shJoshDing/SenkoMicro-SKCS-Firmware/SKSC_Firmware_RevB/Readme.txt

V1.26
1. a GPIO is used to control External power Relay to achive POWER ON and POWER OFF operations;
2. discard debug flashLED();

V1.270/271 2014/08/12
1. uart for power supply control

V1.28 2014/08/12
1. spi flash programe;
2. monite fuse number in flash
