shJoshDing/SenkoMicro-SKCS-Firmware/Hardware Docs/RevC SCH and Gerber/SDP-B GPIO REVC.xlsx

Sheet: Signal Define
CON | Pin Name | Pin Number | IO Number | Signal CTL | High | Low
A | PH1 | 78 | GPIO01
A | PH2 | 44 | GPIO02
A | PH3 | 77 | GPIO03
A | PH0 | 43 | GPIO04
A | PH5 | 76 | GPIO05
A | PH6 | 47 | GPIO06
A | PH7 | 74 | GPIO07
B | PH10 | 43 | GPIO08
B | PH12 | 44 | GPIO09
B | PH14 | 45 | GPIO10
A | PF9 | 37 | GPIO11
A | PF12 | 38 | GPIO12
B | PH15 | 76 | GPIO13
B | PH13 | 77 | GPIO14
B | PH11 | 78 | GPIO15
A | PH8 | 85 | GPIO16
A | PF7 | 31 | GPIO17
A | PF6 | 32 | GPIO18
A | PF3 | 88 | GPIO19
A | PF2 | 92 | GPIO20
B | PF15 | 31 | GPIO21
B | PF14 | 32 | GPIO22
B | PF13 | 87 | GPIO23
B | PG14 | 35 | GPIO24
B | PF11 | 89 | GPIO25
B | PF10 | 90 | GPIO26
B | PF8 | 91 | GPIO27
B | PG15 | 41 | GPIO28

Sheet: Mode Control
IO Name | GPIO2 | GPIO3 | GPIO11 | GPIO4 | Signal Path | Mode | Note
Set 1 | low | low | low | high | AIN -----VCS | Current Measure
Set 2 | low | low | high | high | AIN -----VREF | VREF Measure
Set 3 | low | high | low | high | CONFIG----VCS | X
Set 4 | low | high | high | high | CONFIG----VREF | X
Set 5 | high | low | low | high | AIN-----VOUT | VOUT Measure
Set 6 | high | low | low | low | AIN-----MOUT | MOUT Measure
Set 7 | high | low | high | high | AIN-----510OUT | 510OUT Measure
Set 8 | high | high | low | high | CONFIG----VOUT | Digital Control
Set 9 | high | high | high | high | CONFIG----510OUT | +/-15V Digital Control

Sheet: Power Control
Power | Voltage | Status | GPIO7 | GPIO8 | GPIO9 | GPIO10
VDD | 5V | Power On | high | low | x | x
 | 6V | Power On | low | high | x | x
 | GND | Power Off | high | high | x | x
-15V | -15V | Power On | x | x | low | x
 | GND | Power Off | x | x | high | x
+15V | +15V | Power On | x | x | x | high
 | GND | Power Off | x | x | x | low
