shJoshDing/SenkoMicro-SKCS-Firmware/Hardware Docs/RevB SCH/HDR defines.xlsx

Pin Number | Signal Name
2 | VDD
3 | GND
4 | VOUT
5 | VREF
