shJoshDing/SenkoMicro-SKCS-Firmware/Hardware Docs/RevB SCH/SDP-B GPIO REVB.xlsx

Sheet: Signal Define
CON | Pin Name | Pin Number | IO Number | Signal CTL | High | Low
A | PH1 | 78 | GPIO1 | EVDD | current sensor | no current sensor
A | PH2 | 44 | GPIO2 | SKCS | from Vout/510 out | from VCS/VREF
A | PH3 | 77 | GPIO3 | SKCS | to CONFIG | to AIN
A | PH0 | 43 | GPIO4 | Vout sourse | from Vout | from +/-15V module
A | PH5 | 76 | GPIO5 | Vout & Vref with Cap | without Cap | with Cap
A | PH6 | 47 | GPIO6 | X | X | X
A | PH7 | 74 | GPIO7 | 6VVDD to VDD | OFF | ON
B | PH10 | 43 | GPIO8 | 5V to VDD | OFF | ON
B | PH12 | 44 | GPIO9 | -15V | OFF | ON
B | PH14 | 45 | GPIO10 | +15V | OFF | ON
B | PH6 | 47 | GPIO11 | SKCS | from 510 out/VREF | from VCS/Vout
B | PH7 | 74 | GPIO12 | X | X | X
B | PH15 | 76 | GPIO13 | SDA
B | PH13 | 77 | GPIO14 | SCL
B | PH11 | 78 | GPIO15 | NC | NC | NC

Sheet: Mode Control
IO Name | GPIO2 | GPIO3 | GPIO11 | GPIO4 | Signal Path | Mode | Note
Set 1 | low | low | low | high | AIN -----VCS | Current Measure
Set 2 | low | low | high | high | AIN -----VREF | VREF Measure
Set 3 | low | high | low | high | CONFIG----VCS | X
Set 4 | low | high | high | high | CONFIG----VREF | X
Set 5 | high | low | low | high | AIN-----VOUT | VOUT Measure
Set 6 | high | low | low | low | AIN-----MOUT | MOUT Measure
Set 7 | high | low | high | high | AIN-----510OUT | 510OUT Measure
Set 8 | high | high | low | high | CONFIG----VOUT | Digital Control
Set 9 | high | high | high | high | CONFIG----510OUT | +/-15V Digital Control

Sheet: Power Control
Power | Voltage | Status | GPIO7 | GPIO8 | GPIO9 | GPIO10
VDD | 5V | Power On | high | low | x | x
 | 6V | Power On | low | high | x | x
 | GND | Power Off | high | high | x | x
-15V | -15V | Power On | x | x | low | x
 | GND | Power Off | x | x | high | x
+15V | +15V | Power On | x | x | x | high
 | GND | Power Off | x | x | x | low
