shJoshDing/SenkoMicro-SKCS-Firmware/Hardware Docs/RevC SCH and Gerber/原理图修改说明.docx

## 修改1:

5V的电路从原来的ADP3335改为TPS76201.

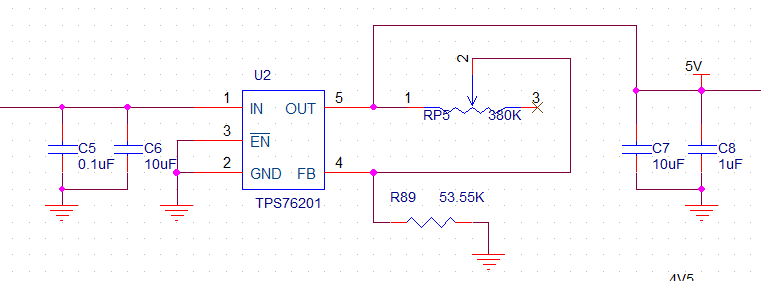
[picture p1: figure]

# 修改2:

6VFUSE增加一路电源

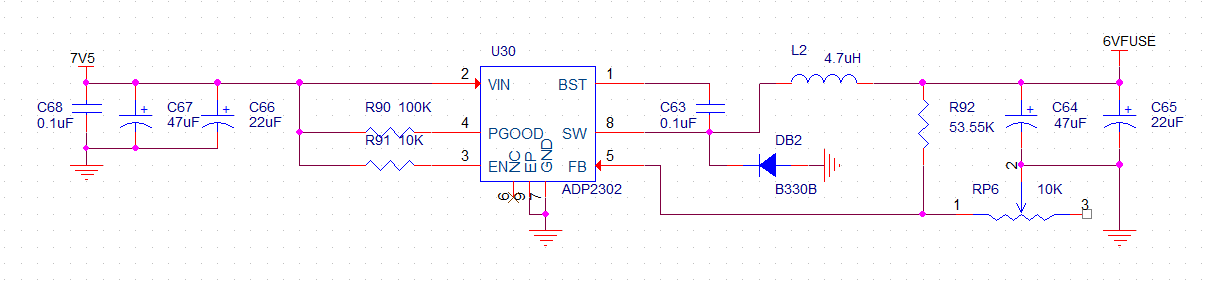
[picture p2: figure]

# 修改3:

移除多余的Relay1-9的测试点

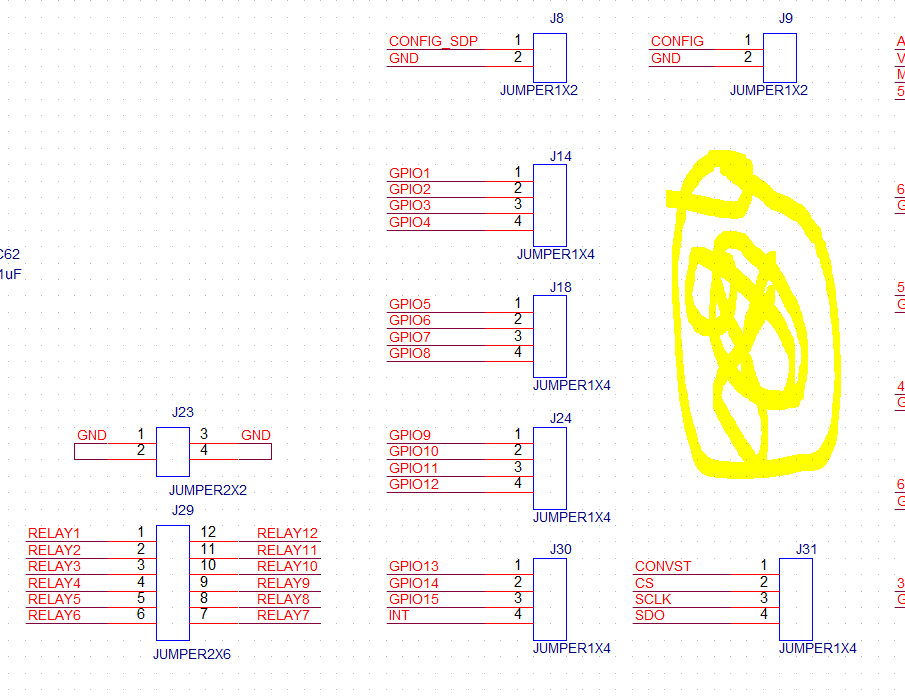
[picture p3: figure]
