shJoshDing/SenkoMicro-SKCS-Firmware/Hardware Docs/BOM of RevC.xlsx

SKCS PROGRAMMING BOARD Revised: Sunday, March 29, 2015
CONNECTOR Revision: <C>
Bill Of Materials March 29,2015 16:36:34 | Page1
Item | Quantity | Reference | Part | Footprint | Soldering
______________________________________________
1 | 3 | B1,B2,B3 | BNC | BNC
2 | 25 | C1,C5,C9,C16,C18,C19,C22,C25,C28,C33,C40,C41,C42,C43,C46,C48,C51,C52,C56,C57,C58,C59,C60,C61,C62 | 0.1uF | C0603
3 | 14 | C2,C3,C6,C7,C10,C14,C17,C20,C21,C29,C30,C36,C45,C50 | 10uF | C0603
4 | 8 | C4,C8,C15,C31,C34,C38,C47,C53 | 1uF | C0603
5 | 1 | C11 | 100uF | D8F3r5MM
6 | 4 | C12,C23,C26,C35 | 47uF | D8F3r5MM
7 | 4 | C13,C24,C27,C37 | 22uF | D8F3r5MM
8 | 1 | C32 | 4.7nF | C0603
9 | 2 | C39,C55 | 47nF | C0603
10 | 1 | C44 | NC | C0603
11 | 2 | C49,C54 | 1nF | C0603
12 | 1 | DB1 | B330B | SMB
13 | 12 | D1,D2,D3,D4,D5,D6,D7,D8,D9,D10,D11,D12 | MBR120VLSF | SOD-123
14 | 1 | FB1 | 600 OHM | B0805
15 | 1 | F1 | FUSE | F1206
16 | 6 | G1,G2,G3,G4,G5,G6 | LED | SLED0603
17 | 1 | HDR1 | COM | DB-25
18 | 1 | HDR2 | COM | DB-9
19 | 13 | J1,J2,J4,J5,J8,J9,J14,J17,J18,J21,J22,J27,J28,J32,J35,J36 | JUMPER1X2 | JUMP2R54MM1X2
20 | 1 | J3 | DC-IN | swc-rapc712
22 | 2 | J6,J7 | FX8-120 | FX8
23 | 10 | J10,J13,J15,J19,J20,J24,J25,J30,J31,J33 | JUMPER1X4 | JUMP254MM1X4
24 | 1 | J11 | JUMPER2X12 | JUMP254MM2X12
25 | 4 | J12,J16,J26,J34 | JUMPER1X3 | JUMP254M1X3
26 | 1 | J23 | JUMPER2X2 | JUMP254M2X2
27 | 1 | J29 | JUMPER2X6 | JUMP254M2X6
28 | 1 | L1 | 4.7uH | L_4R7
29 | 1 | RP1 | 380K | RP3PIN
30 | 1 | RP2 | 48K | RP3PIN
31 | 1 | RP3 | 10K | RP3PIN
32 | 1 | RP4 | 50K | RP3PIN
33 | 2 | R1,R5 | 1M | R0603
34 | 10 | R2,R4,R10,R11,R38,R70,R72,R77,R85,R88 | 10K | R0603
35 | 2 | R3,R7 | 1R | R0805
36 | 1 | R6 | 66.5K | R0603
37 | 7 | R8,R12,R21,R22,R23,R26,R28 | 100K | R0603
38 | 1 | R9 | 53.55K | R0603
39 | 1 | R13 | 13K | R0603
40 | 37 | R14,R16,R18,R20,R25,R29,R31,R32,R33,R36,R37,R39,R40,R41,R42,R43,R44,R45,R61,R62,R63,R64,R65,R66,R67,R68,R69,R71,R74,R76,R78,R79,R81,R82,R83,R84,R87 | 0R | R0603
41 | 18 | R15,R17,R24,R27,R30,R46,R47,R48,R49,R50,R51,R52,R53,R54,R55,R56,R57,R86 | NC | R0603 | no
42 | 1 | R19 | 50K | R0603
43 | 2 | R34,R35 | 2K2 | R0603 | no
44 | 2 | R58,R59 | 500R | R0805
45 | 4 | R60,R73,R75,R80 | 330R | R0805
46 | 1 | U1 | ADP3335ARMZ-3.3-RL7 | MSOP
47 | 2 | U2,U9 | ADP3335ARMZ-5-R7 | MSOP
48 | 2 | U3,U23 | LM358 | SOIC-8
49 | 12 | U4,U7,U8,U11,U15,U16,U17,U18,U20,U22,U28,U30 | G5V-2 | RELAY | u28, u30
50 | 1 | U5 | REF195 | TSSOP
51 | 1 | U6 | TPS76201 | SOT-23
52 | 1 | U10 | ADP2302 | SOIC8_1
53 | 1 | U12 | ADP7104 | SOIC-8
54 | 1 | U13 | FXLP34P5X | SOT-23
55 | 1 | U14 | NC7SZ125 | SOT-23
56 | 1 | U19 | AD7091R | MSOP1
57 | 1 | U21 | AD8655 | MSOP
58 | 2 | U24,U25 | ULN2803 | SOL18
59 | 1 | U26 | ADM3202 | SOP16-50-235
60 | 1 | U27 | PCA9555 | SSOP16 | no
61 | 1 | U29 | M25P16-SO8W | SOP8W
