shJoshDing/SenkoMicro-SKCS-Firmware/Hardware Docs/RevC SCH and Gerber/RevC BOM.xlsx

Designator | Comment | Footprint | LibRef | Quantity
U18 | AD7091R | TSSO3x5-G10 | AD7091R | 1
U20 | AD8655 | SSO-G8/B3 | AD8655 | 1
U25 | ADM3203 | SO-G16 | ADM3203 | 1
U10, U30 | ADP2303 | SO-G8-EPAD | ADP2303 | 2
U1 | ADP3335ARMZ-3.3-R7 | SSO-G8/B3 | ADP3335ARMZ-5-R7 | 1
U9 | ADP3335ARMZ-5-R7 | SSO-G8/B3 | ADP3335ARMZ-5-R7 | 1
U12 | ADP7104 | SO-G8-EPAD | ADP7104 | 1
B1, B2, B3 | BNC | BNC | BNC | 3
C2 | 10uF | C0603(1608) | CAP | 1
C3, C6, C7, C10, C14, C17, C20, C21, C29, C30, C36, C45, C50 | 10uF | C0805(2012) | CAP | 13
C32 | 4.7nF | C0603(1608) | CAP | 1
C39, C55 | 47nF | C0603(1608) | CAP | 2
C4, C8, C31, C34, C38, C47, C53 | 1uF | C0603(1608) | CAP | 7
C44 | NC | C0603(1608) | CAP | 1
C49, C54 | 1nF | C0603(1608) | CAP | 2
C1, C5, C9, C15, C16, C18, C19, C22, C25, C28, C33, C40, C41, C42, C43, C46, C48, C51, C52, C56, C57, C58, C59, C60, C61, C62, C63, C68 | 0.1uF | C0603(1608) | CAP, CAP, CAP, CAP, CAP, CAP, CAP, CAP, CAP, CAP, CAP, CAP, CAP, CAP, CAP, CAP, CAP, CAP, CAP, CAP NP, CAP NP, CAP, CAP NP, CAP NP, CAP NP, CAP NP, CAP, CAP | 28
C11 | 100uF | D8F3R5MM | CAPACITOR POL | 1
C12, C23, C26, C35, C64, C67 | 47uF | D8F3R5MM | CAPACITOR POL | 6
C13, C24, C27, C37, C65, C66 | 22uF | D8F3R5MM | CAPACITOR POL | 6
DB1, DB2 | CD214A-B330 | SMA (DO-214AC) | CD214A-B330 | 2
HDR2 | DB9 | DSUB1.385-2H9A | DB9 | 1
HDR1 | DB25 | DSUB1.385-2H25A | DB25 | 1
J3 | DC-CN | DC-002 | DC-CN | 1
FB1 | 600ohm@100MHz | FB0805 | FB | 1
F1 | Fuse 1A | F1206(3216) | Fuse | 1
J6, J7 | FX8-120 | FX8-120 | FX8-120 | 2
U13 | FXLP34P5X | SO-G5/P.65 | FXLP34P5X | 1
J1, J2, J4, J5, J15, J17, J20, J21, J22, J27, J28, J32 | Header 2X1 | HDR1X2 | Header 2X1 | 12
J24, J25, J31, JP23 | Header 2X2 | HDR2X2 | Header 2X2 | 4
J8 | Header 3X1 | HDR1X3 | Header 3X1 | 1
J12, J26 | Header 3X2 | HDR2X3 | Header 3X2 | 2
J10, J30, J33 | Header 4X1 | HDR1X4 | Header 4X1 | 3
J13, J14 | Header 4X2 | HDR2X4 | Header 4X2 | 2
J11 | Header 12X2 | HDR2X12 | Header 12X2 | 1
L1, L2 | 4.7uH | L_4R7 | INDUCTOR AUDIO | 2
U3, U22 | LM358 | SO-G8 | LM358 | 2
U28 | M25P16 | WSON8 | M25P16 | 1
D1, D2, D3, D4, D5, D6, D7, D8, D9, D10, D11 | MBR120VLSF | SOD-123FL | MBR120VLSF | 11
U14 | NC7SZ125M | SO-G5/X.5 | NC7SZ125M | 1
G1, G2, G3, G4, G5, G6 | LED | OP266 | OP266 | 6
U26 | PCA9555 | TSSO8x6-G24/X.3 | PCA9555 | 1
R58, R59 | 500R | R0603(1608) | R | 2
R61, R72, R76, R81 | 330R | R0603(1608) | R | 4
U5 | REF195 | SO-G8 | REF195 | 1
R1, R5 | 1M | R0603(1608) | RES | 2
R11, R12, R21, R22, R24, R26, R28, R91 | 100k | R0603(1608) | RES | 8
R13 | 13k | R0603(1608) | RES | 1
R15, R17, R23, R27, R38, R46, R47, R48, R49, R50, R51, R52, R53, R54, R55, R56, R57, R86 | NC | R0603(1608) | RES | 18
R19 | 50k | R0603(1608) | RES | 1
R3 | 1R | R0603(1608) | RES | 1
R33, R35 | 2.2k | R0603(1608) | RES | 2
R6 | 66.5k | R0603(1608) | RES | 1
R7, R89, R92 | 53.55k | R0603(1608) | RES | 3
R8 | 1R | R1210(3226) | RES | 1
R2, R4, R9, R10, R37, R71, R75, R78, R85, R88, R90 | 10k | R0603(1608) | RES, RES, RES, RES, RES, R, R, RES, R, RES, RES | 11
R14 | 0R | R1210(3226) | Resistor | 1
R16, R18, R20, R25, R29, R30, R31, R32, R34, R36, R39, R40, R41, R42, R43, R44, R45, R60, R62, R63, R64, R65, R66, R67, R68, R69, R70, R73, R74, R77, R79, R80, R82, R83, R84, R87 | 0R | R0603(1608) | Resistor, RES, RES, RES, RES, RES, RES, RES, RES, RES, RES, RES, RES, RES, RES, RES, RES, RES, RES, RES, RES, RES, RES, RES, RES, RES, RES, RES, RES, RES, RES, RES, RES, RES, RES, RES | 36
1, 2, 3, 4 | ROB | ROB | ROB | 4
RP1, RP5 | 380k | VR5 | RPot | 2
RP2 | 48k | VR5 | RPot | 1
RP3, RP6 | 10.2k | VR5 | RPot | 2
RP4 | 50k | VR5 | RPot | 1
U2, U6 | TPS76201 | SO-G5/X.5 | TPS76201 | 2
U4, U7, U8, U11, U15, U16, U17, U19, U21, U27, U29 | TQ2-5V | TQ2-5V-2C | TQ2-5V | 11
U23, U24 | ULN2803 | SO-G18/E7 | ULN2803 | 2
