shJoshDing/SenkoMicro-SKCS-Firmware/Hardware Docs/RevB SCH/SKCS PROGRAMMING BOARD_protel 20141125B_sch.pdf

## CLOSE TO HDR

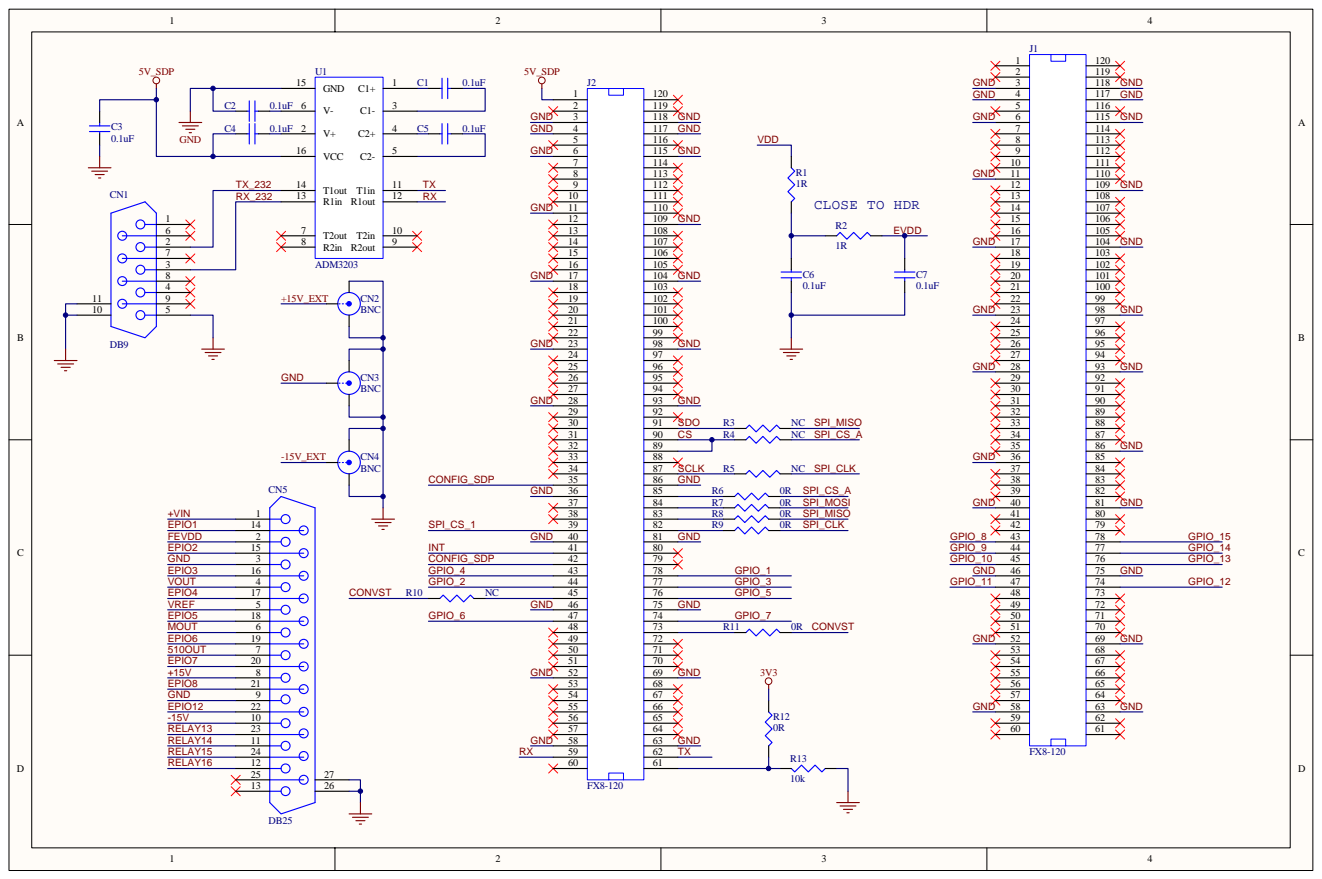
[picture p4: page 1]

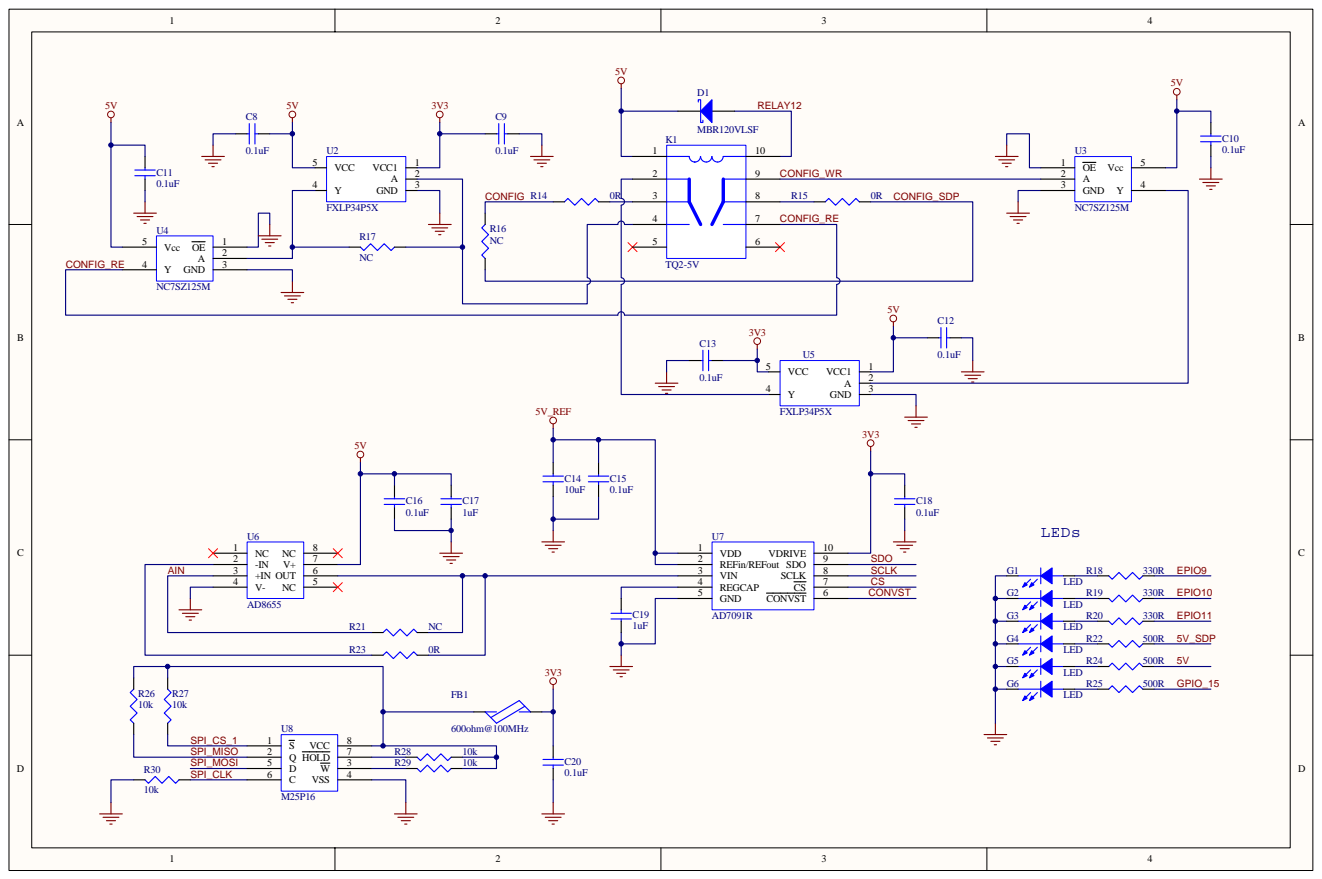
[picture p5: page 2]

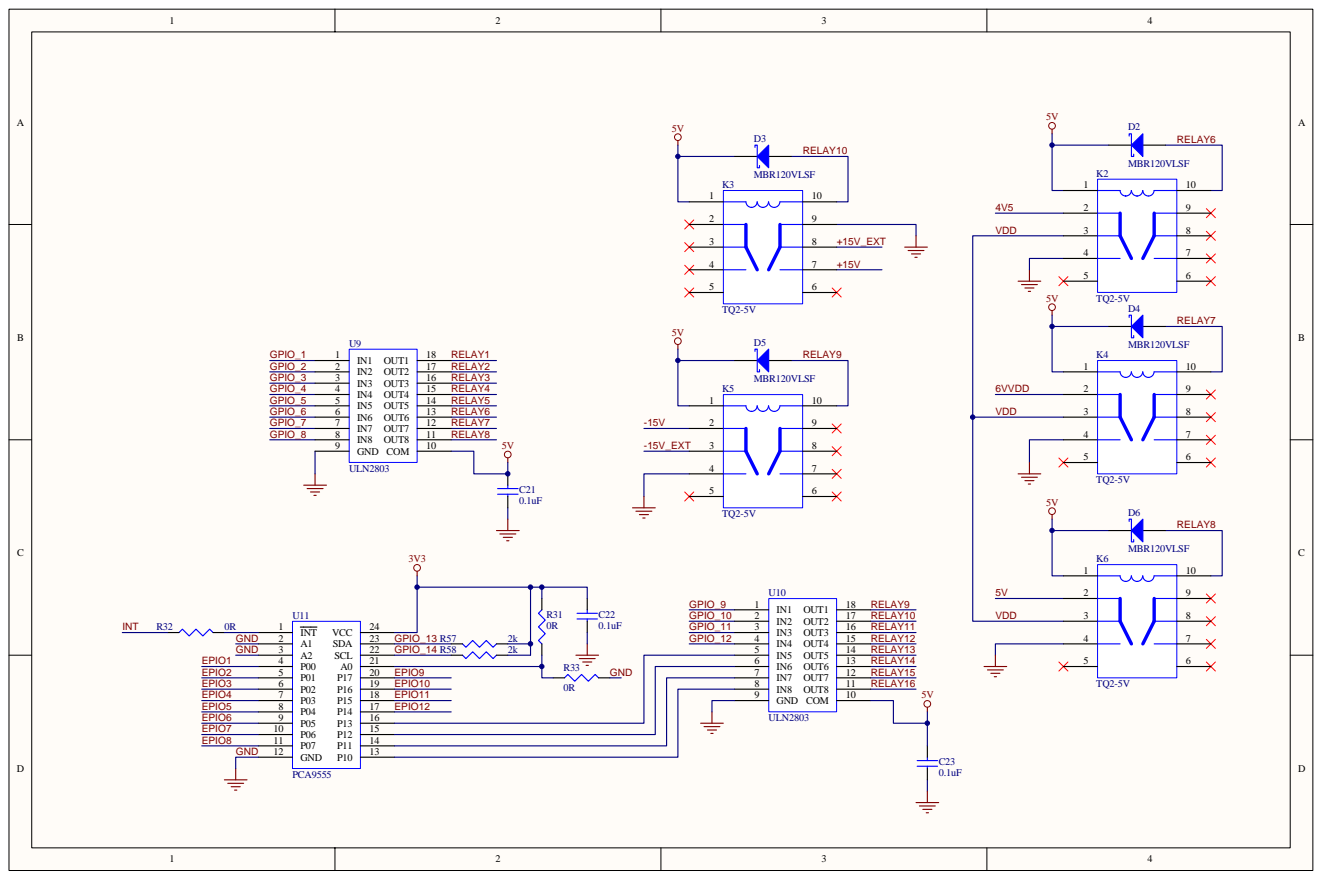
[picture p6: page 3]

## VOUT TRACE AS SHORT AS POSSIABLE

## Vo = I * 1R * 2M/10K

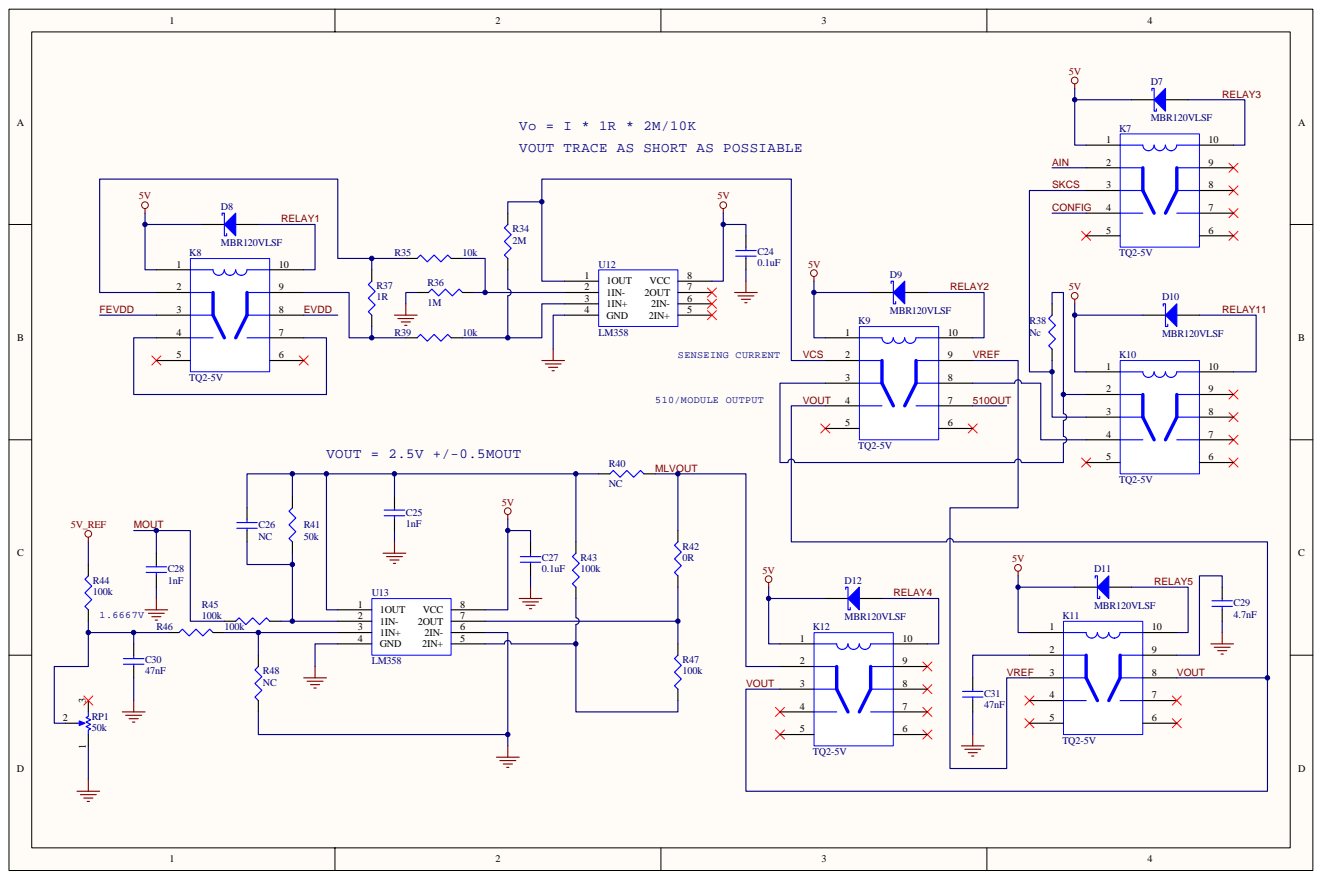
[picture p7: page 4]

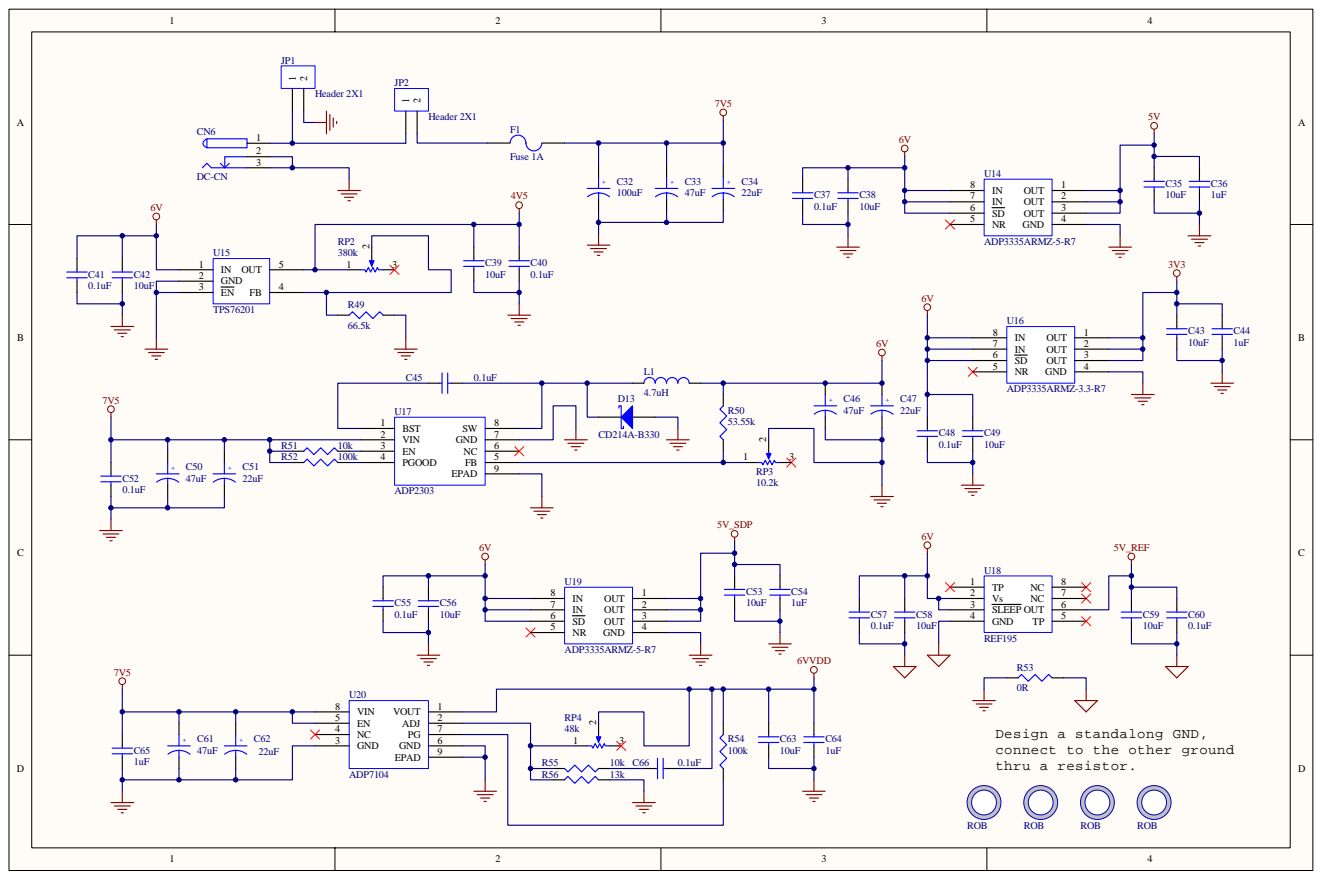
[picture p8: page 5]

Design a standalong GND,
connect to the other ground
thru a resistor.

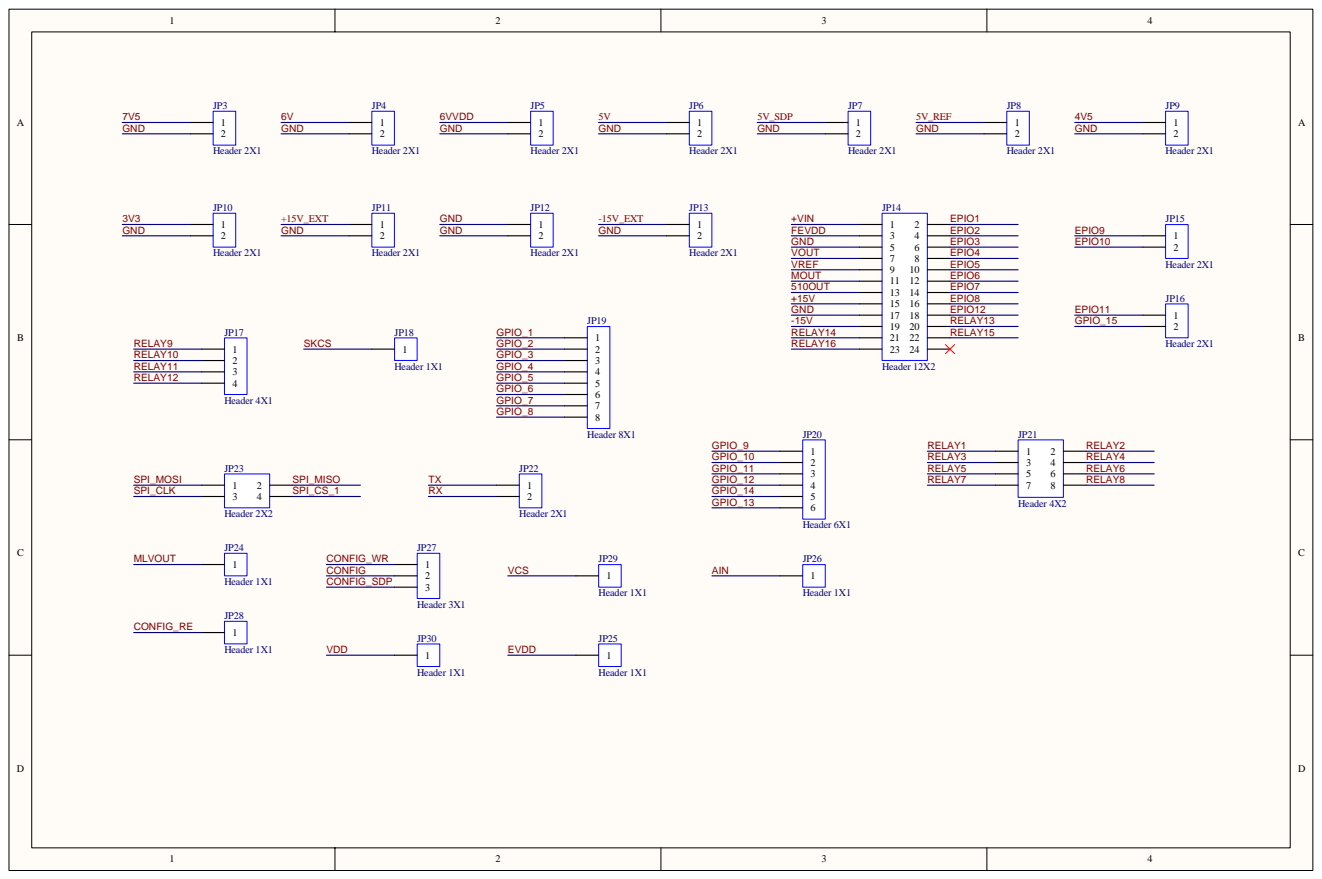
[picture p9: page 6]
