shJoshDing/SenkoMicro-SKCS-Firmware/Hardware Docs/RevC SCH and Gerber/protel/SCH20150513A_protel.pdf

## VCS = I * 1R * 2M/10K

## LEDs

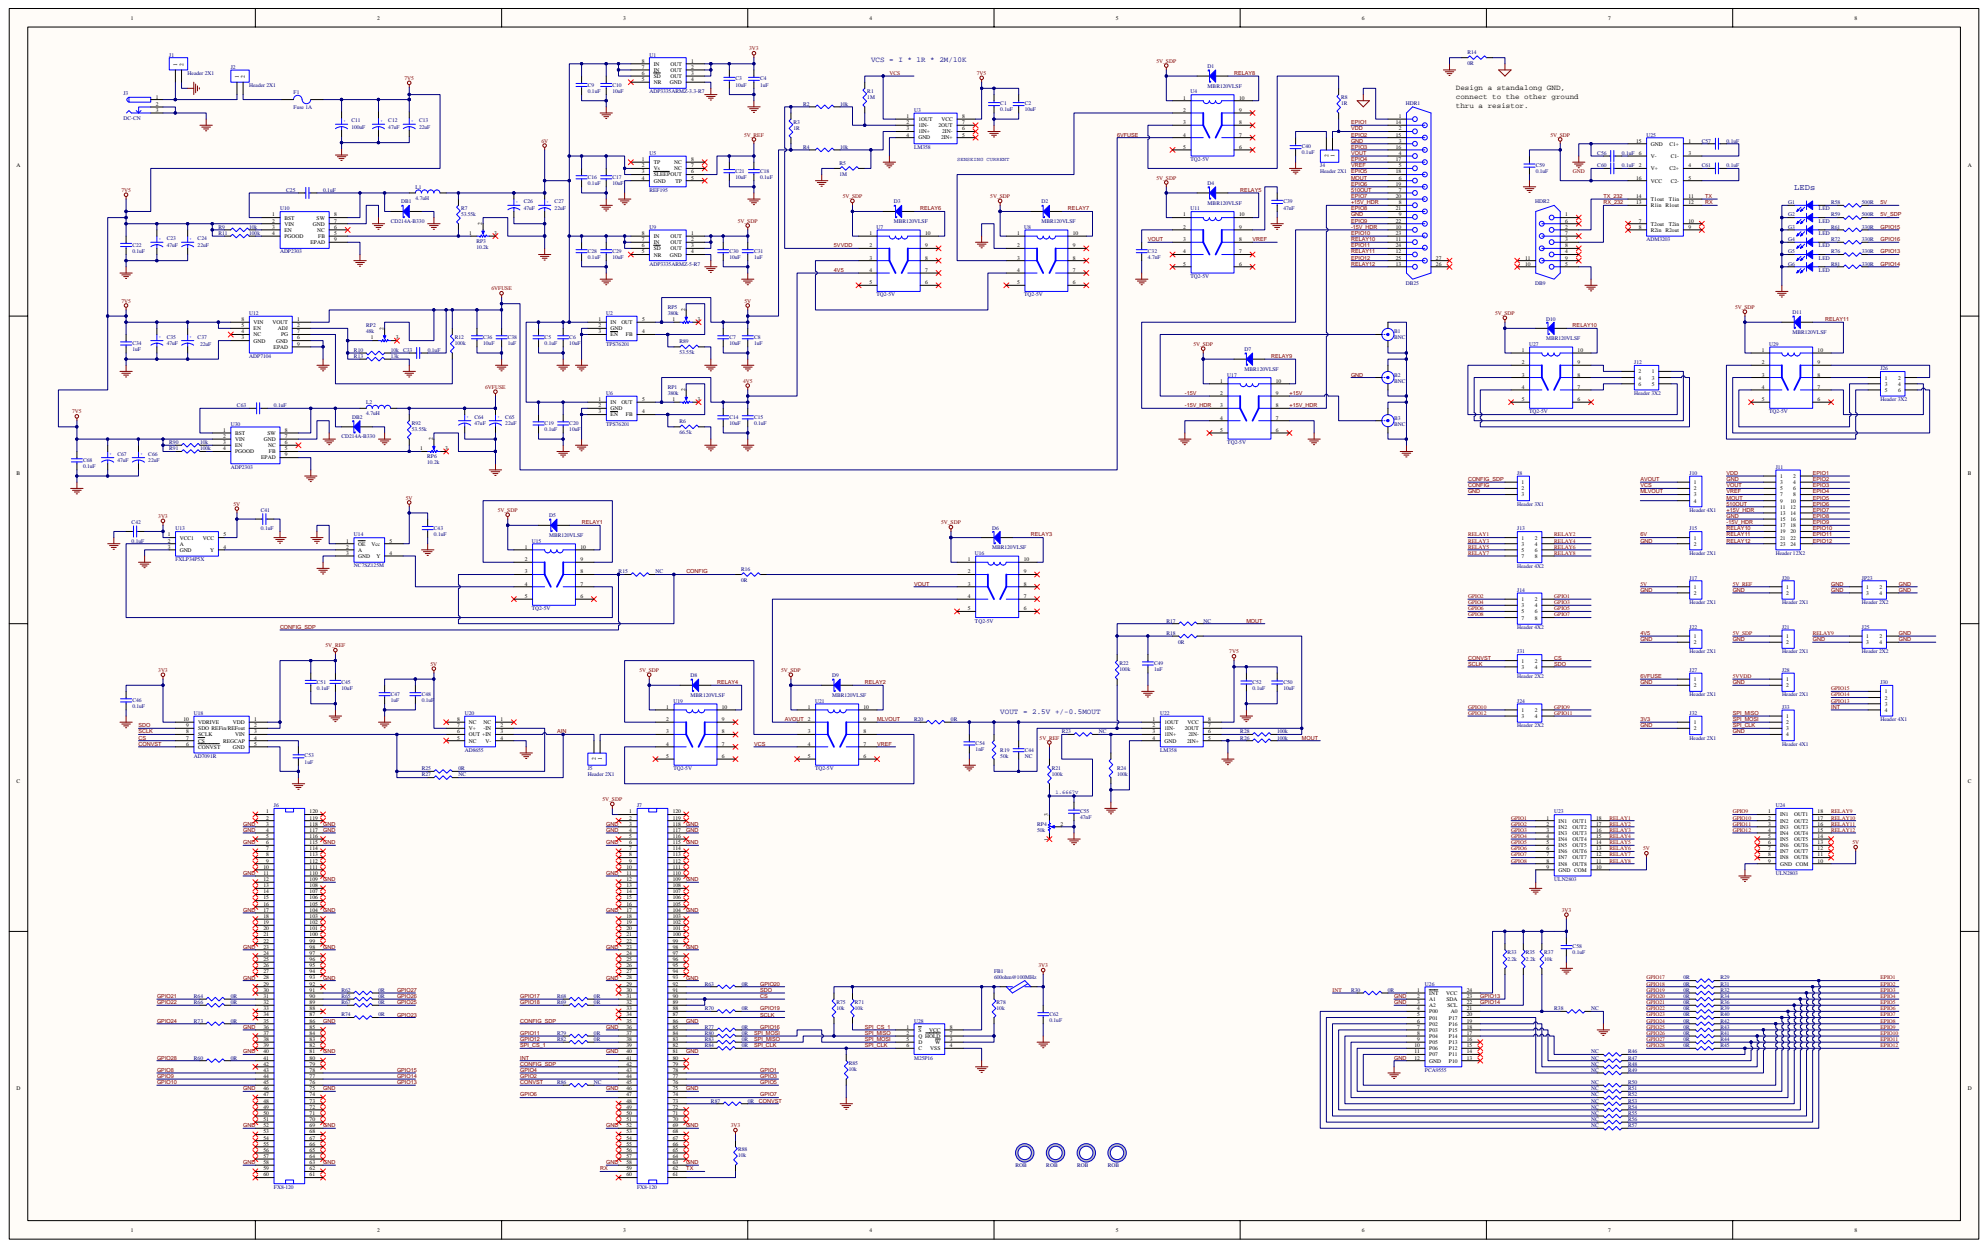
[picture p10: page 1]

Design a standalong GND,
connect to the other ground
thru a resistor.

C | CONFIG_SDP Header 4X2 1 1 1 2 2 2 3 4 5V_REF | C
