shJoshDing/SenkoMicro-SKCS-Firmware/Hardware Docs/RevC SCH and Gerber/cadence/sch20150506a.pdf

修改1 | 5V

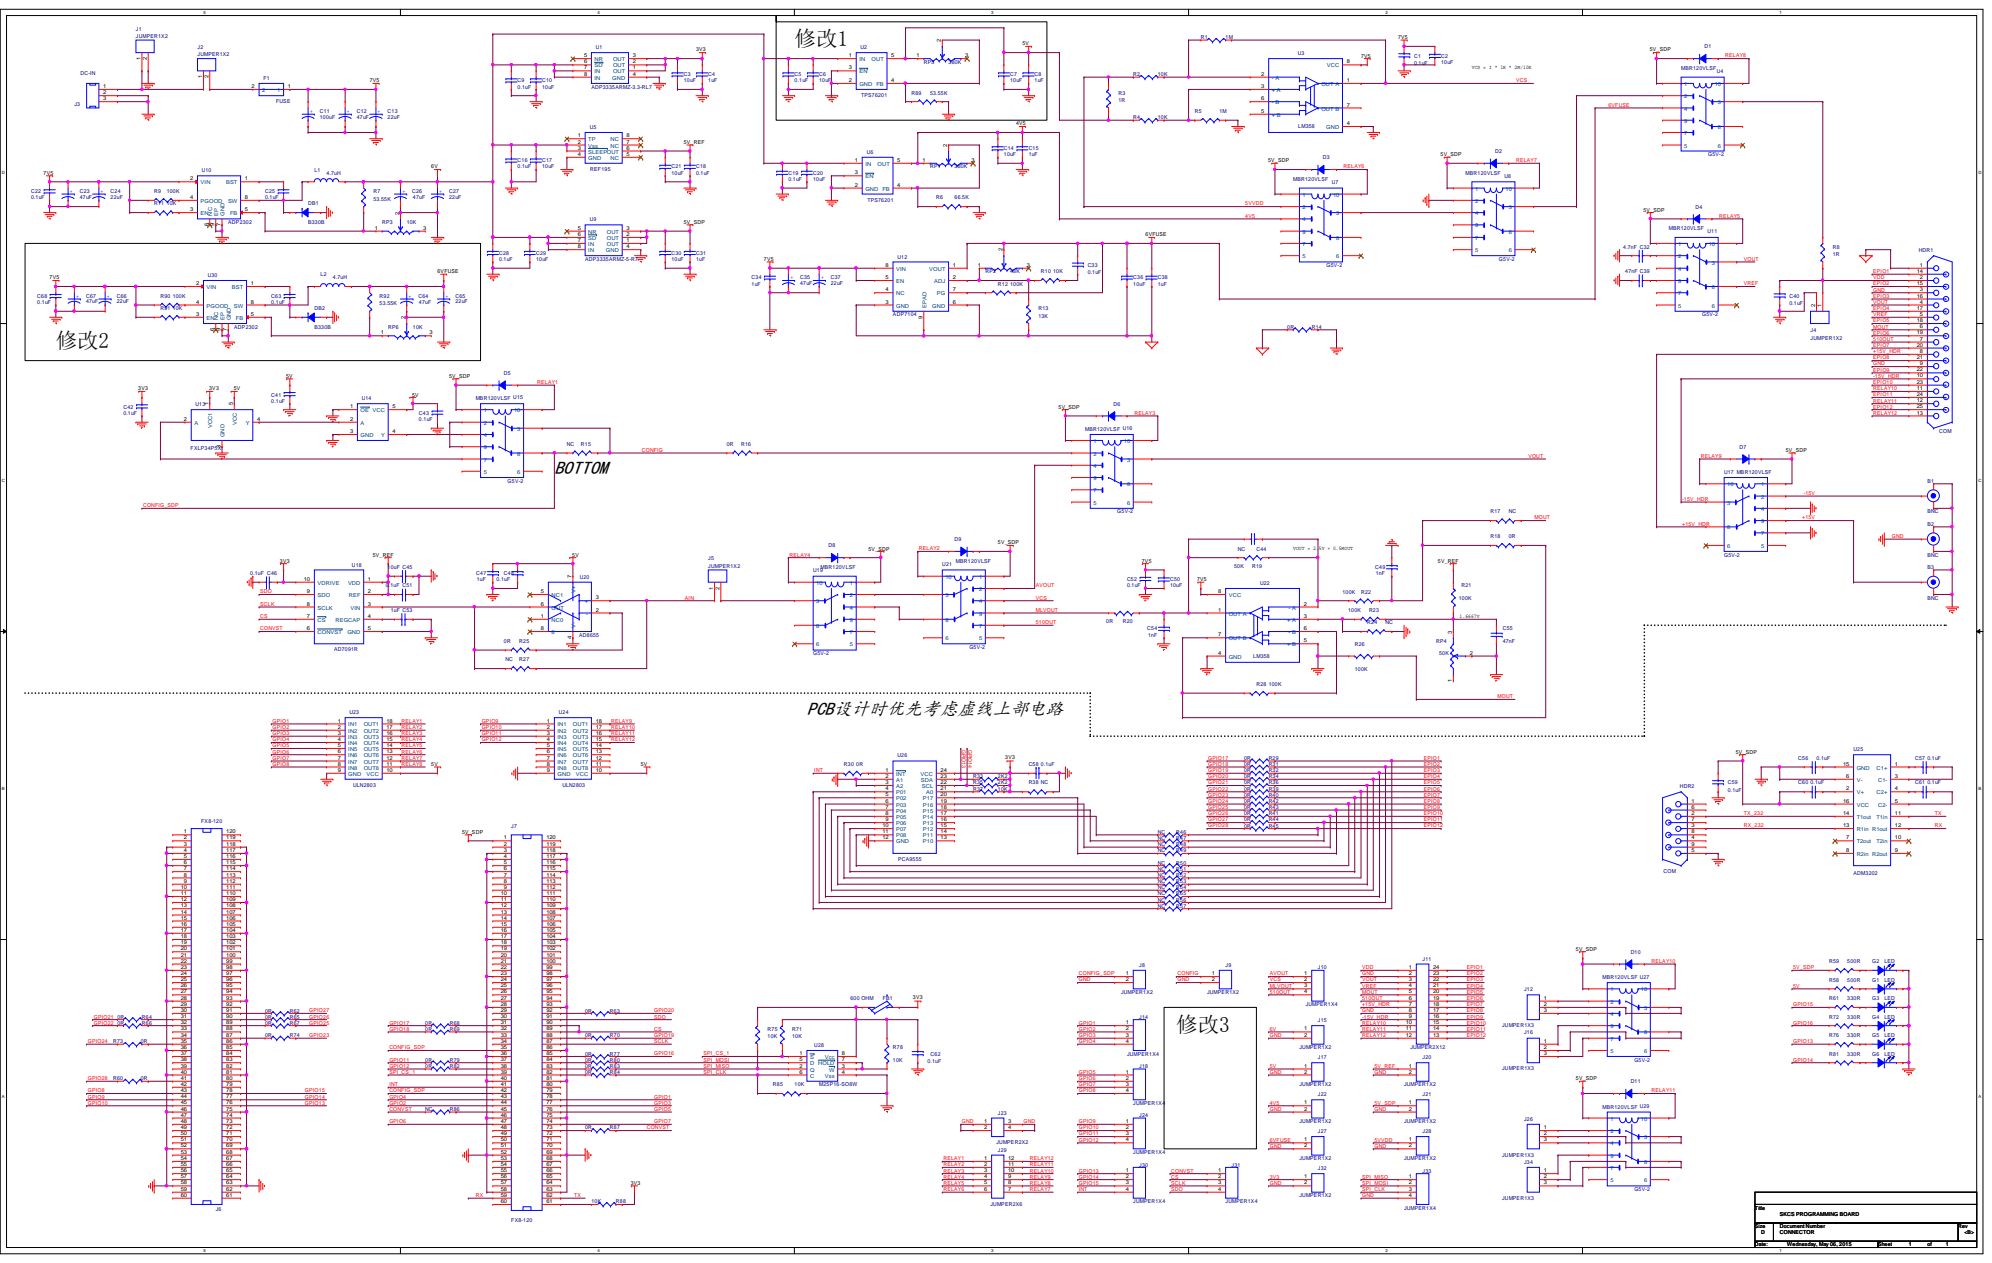
[picture p11: page 1]
