shJoshDing/SenkoMicro-SKCS-Firmware/Hardware Docs/RevC SCH and Gerber/Assembly Drawings 20150515A.pdf

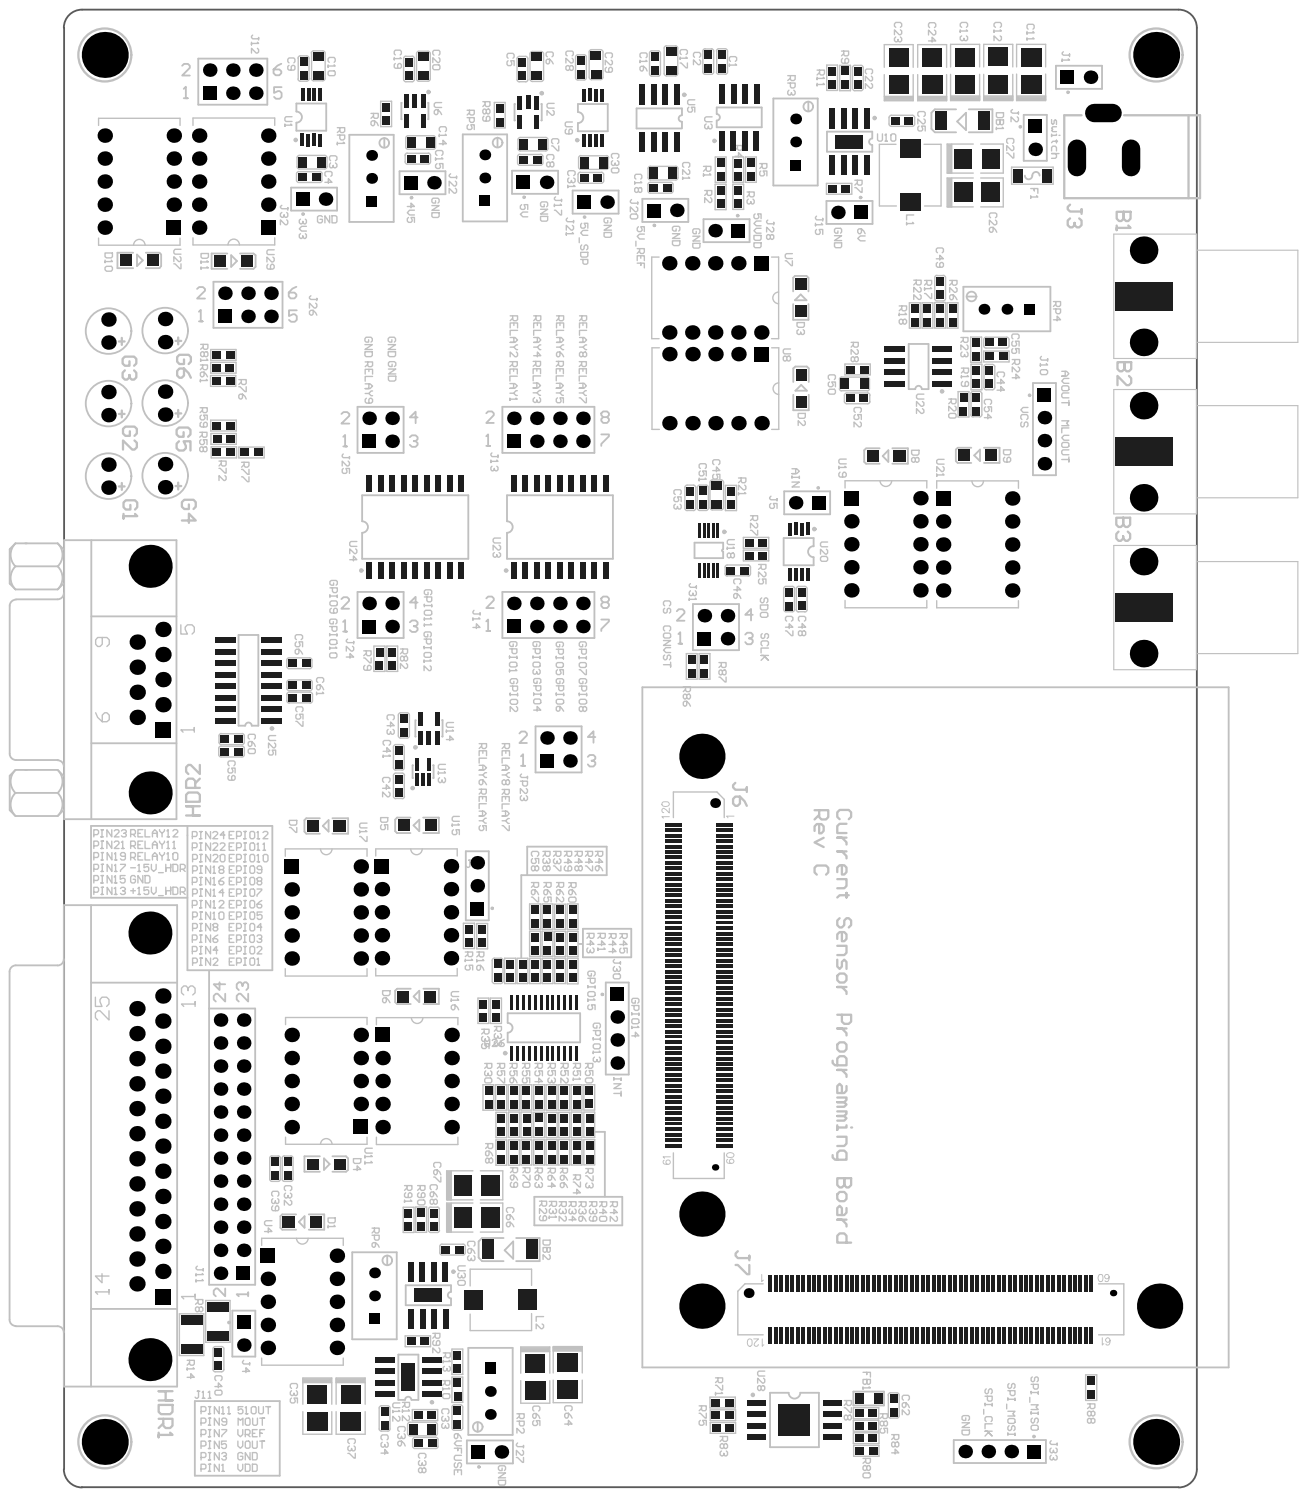
[picture p12: page 1]
