shJoshDing/SenkoMicro-SKCS-Firmware/(list of files, drawings)

Other design files:
Hardware Docs/RevC SCH and Gerber/cadence/SCH20150506A.DSN
