shJoshDing/SenkoMicro-SKCS-Firmware/SKSC_Firmware_RevB/CurrentSensor_heaptab.c

/* MANAGED-BY-SYSTEM-BUILDER                                    */
/* VisualDSP++ 5.1.1                                            */
/* LDF Printer version: 5.9.0.1                                 */
/* ldfgen.exe version: 5.9.0.1                                  */
/* VDSG version: 5.9.0.1                                        */

/*
** User heap source file generated on Jul 23, 2014 at 19:27:42.
**
** Copyright (C) 2000-2010 Analog Devices Inc., All Rights Reserved.
**
** This file is generated automatically based upon the options selected
** in the LDF Wizard. Changes to the LDF configuration should be made by
** changing the appropriate options rather than editing this file.
**
** Configuration:-
**     crt_doj:                                CurrentSensor_basiccrt.doj
**     processor:                              ADSP-BF527
**     product_name:                           VisualDSP++ 5.1.1
**     si_revision:                            0.2
**     default_silicon_revision_from_archdef:  0.2
**     using_cplusplus:                        true
**     mem_init:                               false
**     use_vdk:                                false
**     use_mt:                                 false
**     use_eh:                                 true
**     use_argv:                               true
**     running_from_internal_memory:           true
**     user_heap_src_file:                     D:\PORJECT\SKCS\FW\SKSC_FW - v1.2.6\CurrentSensor_heaptab.c
**     libraries_use_stdlib:                   true
**     libraries_use_fileio_libs:              false
**     libraries_use_ieeefp_emulation_libs:    false
**     libraries_use_eh_enabled_libs:          false
**     libraries_use_fixed_point_io_libs:      false
**     libraries_use_utility_rom:              true
**     detect_stackoverflow:                   false
**     system_heap:                            L1
**     system_heap_min_size:                   2k
**     system_stack:                           L1
**     system_stack_min_size:                  2k
**     use_sdram:                              true
**     use_sdram_size:                         32MB
**     use_sdram_partitioned:                  default
**
*/


#ifdef _MISRA_RULES
#pragma diag(push)
#pragma diag(suppress:misra_rule_1_1)
#pragma diag(suppress:misra_rule_2_2)
#pragma diag(suppress:misra_rule_6_3)
#pragma diag(suppress:misra_rule_8_10)
#pragma diag(suppress:misra_rule_10_1_a)
#pragma diag(suppress:misra_rule_11_3)
#pragma diag(suppress:misra_rule_12_7)
#else
#pragma diag(suppress:1124)
#endif /* _MISRA_RULES */



extern "asm" int ldf_heap_space;
extern "asm" int ldf_heap_length;


struct heap_table_t
{
  void          *base;
  unsigned long  length;
  long int       userid;
};

#pragma file_attr("libData=HeapTable")
#pragma section("constdata")
struct heap_table_t heap_table[2] =
{


  { &ldf_heap_space, (unsigned long) &ldf_heap_length, 0 },


  { 0, 0, 0 }
};



#ifdef _MISRA_RULES
#pragma diag(pop)
#endif /* _MISRA_RULES */
