shJoshDing/SenkoMicro-SKCS-Firmware/SKSC_Firmware_RevB/SDP_adc.c

// SDP_sport.c

#include "SDP_std_include.h"
#include "SDP_adc.h"
#include <string.h>
//#include "SDP_general_functions.h"


#define DEBUG

#define MAX_SAMPLES_NUMBER_CAPTURE 	2048
#define SPI_CLK_PIN 				PF5
#define SPI_SS_PIN 					PF1
#define SPI_MISO_PIN 				PF0
#define SPI_CONVST_PIN 				PG5
//#define RELAY_1						0x0002
//#define RELAY_2						0x0004
//#define RELAY_3						0x0008
//#define RELAY_4						0x0040
//#define RELAY_5						0x0020
//#define RELAY_POWERON				0x0400
//#define MODULE_15V_OUT				0x1000





bool bPowerVolt = false;
bool bAdcReset = false;
bool bInitGpiosForADC = false;
bool bInitGpiosForSignalPath = false;


u16 gAdcDataBuffer[MAX_SAMPLES_NUMBER_CAPTURE];






#ifdef DEBUG
u16 testArray[0xFFFF];
#endif
//memset(testArray, 0xAA, sizeof(testArray));

//-----------------------------------------------------------------------------
void processADCCmd(SDP_USB_HEADER *pUsbHeader)
{
	switch (pUsbHeader->cmd)
	{
		case ADI_SDP_CMD_ADC_TRANSFER:
			//captureAdcData( pUsbHeader->downByteCount, pUsbHeader->upByteCount);
			captureAdcData( pUsbHeader->downByteCount, pUsbHeader->upByteCount);
			break; 
			
		case ADI_SDP_CMD_ADC_RESET:
			//sportStreamFrom(pUsbHeader->paramArray);
			adcReset();
			break;
			
		case ADI_SDP_CMD_ADC_SIGNAL_PATH:
			//sportStreamFrom(pUsbHeader->paramArray);
			adcSignalPath( pUsbHeader->numParam );
			break;
			
		case ADI_SDP_CMD_ADC_SIGPATH_INIT:
			initialGpiosForSignalPath();
			break;
			
			
		default:
			unknownCommand(pUsbHeader);
			break;
	}
}

//-----------------------------------------------------------------------------
static void captureAdcData(u32 adcConvstFreq, u32 sampleNumbers )
{
	u16 i;
	u8 j = 0;
	
	if( sampleNumbers > MAX_SAMPLES_NUMBER_CAPTURE)
	{
		sampleNumbers = MAX_SAMPLES_NUMBER_CAPTURE;
	}

	for( i =0; i<sampleNumbers; i++ )
	{
		gAdcDataBuffer[i] = signalSampleAdc( adcConvstFreq );
		#ifdef DEBUG
		testArray[i]=i;
		#endif
	}
	
	j = sampleNumbers/256;						//calc usb pacakge numbers
	for( i = 0; i<j ; i++ )
	{
		usbSendBulkData( (gAdcDataBuffer + 256*i),512,false);
		waitMilliSec(50);
		//flashLed();
	}
	
	if( sampleNumbers%256 > 0)					//not a multiple of 512, +1, last pacakge size is not 512
	{
		usbSendBulkData( (gAdcDataBuffer + 256*j),2*(sampleNumbers - 256*j),false);
	}
}

//-----------------------------------------------------------------------------
static void adcSignalPath( u32 pathID )
{
	if( !bInitGpiosForSignalPath )
	{
		initialGpiosForSignalPath();
		
		#ifdef DEBUG00
		flashLed();
		#endif
	}
	
	//flashLed();
	
	switch ( pathID )
	{
		case ADC_VOUT_WITH_CAP:				//0X61
			*pPORTHIO_CLEAR = GPIO_5;
			#ifdef DEBUG
			flashLed();
			#endif
			//adcVoutCap( true );
			break;
		
		case ADC_VOUT_WITHOUT_CAP:			//0X62
			*pPORTHIO_SET = GPIO_5;
			//adcVoutCap( false );
			#ifdef DEBUG
			flashLed();
			#endif
			break;
			
		case ADC_VREF_WITH_CAP:				//0X63
			*pPORTHIO_CLEAR = GPIO_5;
			//adcVrefCap( true );
			#ifdef DEBUG
			flashLed();
			#endif
			break;
			
		case ADC_VREF_WITHOUT_CAP:			//0X64
			*pPORTHIO_SET = GPIO_5;
			//adcVrefCap( false );
			#ifdef DEBUG
			flashLed();
			#endif
			break;
			
		case ADC_VIN_TO_VOUT:				//0X65
			//flashLed();
			*pPORTHIO_CLEAR = ( GPIO_3|GPIO_11);
			ssync();
			ssync();
			*pPORTHIO_SET = ( GPIO_2|GPIO_4 );
			//*pPORTHIO_CLEAR |= RELAY_2;
			//adcSetVinToVout( true );
			#ifdef DEBUG
			flashLed();
			#endif
			break;
			
		case ADC_VIN_TO_VREF:				//0X66
			*pPORTHIO_CLEAR = ( GPIO_3|GPIO_2);
			ssync();
			ssync();
			*pPORTHIO_SET = ( GPIO_4 | GPIO_11 );
			//flashLed();
			//*pPORTHIO_CLEAR = RELAY_2;
			//ssync();
			//ssync();
			//*pPORTHIO_SET = RELAY_1;
			//ssync();
			//ssync();
			//adcSetVinToVout( false );
			#ifdef DEBUG
			flashLed();
			#endif
			break;
			
		case ADC_CONFIG_TO_VOUT:			//0X67
			*pPORTHIO_CLEAR = ( GPIO_11 );
			ssync();
			ssync();
			*pPORTHIO_SET = ( GPIO_2|GPIO_3 | GPIO_4 );
			//*pPORTHIO_CLEAR = RELAY_1;

			//*pPORTHIO_SET = RELAY_2;
			//ssync();
			//ssync();
			//adcSetConfigToVout( true );
			#ifdef DEBUG
			flashLed();
			#endif
			break;
			
		case ADC_CONFIG_TO_VREF:			//0X68
			//*pPORTHIO_CLEAR = ( GPIO_2|GPIO_3|GPIO_11 );
			//*pPORTHIO_SET = (RELAY_1|RELAY_2);
			//*pPORTHIO_SET |= RELAY_2;
			//adcSetConfigToVout( false );
			#ifdef DEBUG
			flashLed();
			#endif
			break;
		
		case ADC_VDD_FROM_EXT:				//0x69
			//*pPORTHIO_SET = GPIO_8;
			ssync();
			ssync();
			//*pPORTHIO_CLEAR = GPIO_7;
			bPowerVolt = true;
			//*pPORTHIO_SET = RELAY_5;
			//adcSetVddFromExt( true );
			#ifdef DEBUG
			flashLed();
			#endif
			break;
		
		case ADC_VDD_FROM_5V:
			//*pPORTHIO_SET = GPIO_7;
			ssync();
			ssync();
			//*pPORTHIO_CLEAR = GPIO_8;				//0x6A
			bPowerVolt = false;
			//*pPORTHIO_CLEAR = RELAY_5;
			//adcSetVddFromExt( false );
			#ifdef DEBUG
			flashLed();
			#endif
			break;
			
		case ADC_VDD_POWER_ON:	
			if( bPowerVolt == true )
			{
				*pPORTHIO_SET = GPIO_8 | GPIO_10;
				ssync();
				//flashLed();
				ssync();
				*pPORTHIO_CLEAR = GPIO_7 | GPIO_9;
			}
			else if( bPowerVolt == false )
			{
				*pPORTHIO_SET = GPIO_7 | GPIO_10;
				ssync();
				ssync();
				*pPORTHIO_CLEAR = GPIO_8 | GPIO_9;		
			}
		
			//*pPORTHIO_SET = RELAY_POWERON;
			//adcSetVddFromExt( false );
			#ifdef DEBUG
			flashLed();
			#endif
			break;
			
		case ADC_VDD_POWER_OFF:					//0x6C
			*pPORTHIO_CLEAR = GPIO_10;
			//*pPORTHIO_SET = GPIO_7;
			ssync();
			ssync();
			*pPORTHIO_SET = GPIO_8 | GPIO_7 | GPIO_9 ;
			//adcSetVddFromExt( false );
			#ifdef DEBUG
			flashLed();
			#endif
			break;
			
		case ADC_MODULE_510OUT:
			//*pPORTHIO_SET = GPIO_2 | GPIO_3 | GPIO_11;
			//*pPORTHIO_CLEAR = MODULE_15V_OUT;
			//adcSetVddFromExt( false );
			#ifdef DEBUG
			flashLed();
			#endif
			break;			
			
		case ADC_MODULE_AMPOUT:
			//*pPORTHIO_CLEAR = ( GPIO_3|GPIO_11|GPIO_4);
			ssync();
			ssync();
			//*pPORTHIO_SET = ( GPIO_2 );
			//*pPORTHIO_SET = MODULE_15V_OUT;
			//adcSetVddFromExt( false );
			#ifdef DEBUG
			flashLed();
			#endif
			break;
						
		
		case ADC_VIN_TO_VCS:
			*pPORTHIO_CLEAR = ( GPIO_3|GPIO_2|GPIO_11);
			ssync();
			ssync();
			*pPORTHIO_SET = ( GPIO_4 );
			//*pPORTHIO_SET = MODULE_15V_OUT;
			//adcSetVddFromExt( false );
			#ifdef DEBUG
			flashLed();
			#endif
			break;
			
		case ADC_SET_CURRENT_SENCE:
			*pPORTHIO_CLEAR = GPIO_1;
			ssync();
			#ifdef DEBUG
			flashLed();
			#endif
			break;	
			
		case ADC_BYPASS_CURRENT_SENCE:
			*pPORTHIO_SET = GPIO_1;
			ssync();
			#ifdef DEBUG
			flashLed();
			#endif
			break;
			
		case ADC_VIN_TO_510OUT:
			*pPORTHIO_CLEAR = GPIO_3;
			ssync();
			ssync();
			*pPORTHIO_SET = GPIO_2 | GPIO_4 | GPIO_11;
			#ifdef DEBUG
			flashLed();
			#endif
			break;
			
		case ADC_VIN_TO_MOUT:
			*pPORTHIO_CLEAR = GPIO_3 | GPIO_4 | GPIO_11;
			ssync();
			ssync();
			*pPORTHIO_SET = GPIO_2;
			#ifdef DEBUG
			flashLed();
			#endif
			break;
			
		case ADC_CONFIG_TO_510OUT:
			*pPORTHIO_SET = GPIO_2 | GPIO_3 | GPIO_4 | GPIO_11;
			ssync();
			ssync();
			#ifdef DEBUG
			flashLed();
			#endif
			break;
			
		case ADC_TRIM_RESULT_PASS:
			*pPORTHIO_SET = GPIO_15;
			ssync();
			ssync();
			#ifdef DEBUG
			flashLed();
			#endif
			break;
			
		case ADC_TRIM_RESULT_FAIL:
			*pPORTHIO_CLEAR = GPIO_15;
			ssync();
			ssync();
			#ifdef DEBUG
			flashLed();
			#endif
			break;
					
			
			
		default:
			break;
	} 

}
		                 
		                 
//-----------------------------------------------------------------------------
static u16 signalSampleAdc( u32 adcConvstFreq )
{
	u16 j = 0;
	u8 i;
	u8 delayCounter;
	u16 readValue = 0;
	bool cpha = true;
	bool cpol = false;
	u32 clkCount;
	
	//clkCount = 600000000/adcConvstFreq;
	clkCount = 600;						// adcConvstFreq = 1MHz
	
	*pTCNTL &= ~TMREN;
	ssync();
	*pTSCALE = 0x0;
	*pTPERIOD = clkCount;
	*pTCNTL = 0x01;
	*pTCOUNT = 300;
	ssync();	

	
	if( !bAdcReset )
	{
		adcReset();
		//bAdcReset = true;
	}
	
	delayCounter = 10;					//200ns
	*pPORTGIO_CLEAR = SPI_CONVST_PIN;	//start of t7
	while(delayCounter--){}
	*pPORTGIO_SET = SPI_CONVST_PIN;		 //end of t7
	
	delayCounter = 20;					//200ns			
	while(delayCounter--){}
	*pPORTFIO_CLEAR = SPI_SS_PIN;
	
	delayCounter = 5;					//200ns			
	while(delayCounter--){}

	for(i = 0; i<12; i++)
	{
		readValue <<= 1;
		*pPORTFIO_SET = SPI_CLK_PIN;
		//*pTCNTL &= ~TMREN;
		//ssync();
		*pTCOUNT = 300;
		ssync();
		*pTCNTL |= TMREN;
		ssync();
		if (*pPORTFIO & SPI_MISO_PIN)
			readValue |= 0x0001;
		while ( *pTCOUNT > 26 ); 
		*pPORTFIO_CLEAR = SPI_CLK_PIN;
		//*pTCNTL &= ~TMREN;
		//ssync();
		*pTCOUNT = 300;
		ssync();
		*pTCNTL |= TMREN;
		ssync();
		while ( *pTCOUNT > 26 );
		
	}

	*pPORTFIO_SET = SPI_SS_PIN;
	
	return readValue;			
}


//-----------------------------------------------------------------------------
static void adcReset(void)
{
	u8 i;
	u8 delayCounter;
	
	if( !bInitGpiosForADC )
	{
		initialGPIOsforADC();
		//bInitGpiosForADC = true;
	}
		
	delayCounter = 10;						//200ns
	//delayCounter = 20;					//400ns
	*pPORTGIO_CLEAR = SPI_CONVST_PIN;		//start of t7
	while(delayCounter--){}
	*pPORTGIO_SET = SPI_CONVST_PIN;		  	//end of t7
	
	delayCounter = 20;
	while(delayCounter--){}
	*pPORTFIO_CLEAR = SPI_SS_PIN;
	ssync();
	
	for(i=0; i<4; i++)
	{
		*pPORTFIO_CLEAR = SPI_CLK_PIN;
		delayCounter = 25;					//500ns
		while(delayCounter--){}
		*pPORTFIO_SET = SPI_CLK_PIN;
		delayCounter = 25;					//500ns
		while(delayCounter--){}
	}
	
	*pPORTFIO_SET = SPI_SS_PIN;	
	*pPORTFIO_CLEAR = SPI_CLK_PIN;
	
	//bAdcReset = true;
	
}


//-----------------------------------------------------------------------------
static void initialGPIOsforADC(void)
{
	//PG7 = CONVST	
	*pPORTG_FER &= ~(SPI_CONVST_PIN);
	*pPORTGIO_INEN &= ~SPI_CONVST_PIN;
	*pPORTGIO_SET |= SPI_CONVST_PIN;
	*pPORTGIO_DIR |= SPI_CONVST_PIN;
	
	//PF1 & PF4 = CS
	*pPORTF_FER &= ~(SPI_SS_PIN);
	*pPORTFIO_INEN &= ~SPI_SS_PIN;
	*pPORTFIO_SET |= SPI_SS_PIN;
	*pPORTFIO_DIR |= SPI_SS_PIN;
	
	*pPORTF_FER &= ~(PF4);
	*pPORTFIO_INEN |= PF4;
	*pPORTFIO_DIR &= ~PF4;
	
	//PF2 & PF5 = CLK
	*pPORTF_FER &= ~(SPI_CLK_PIN);
	*pPORTFIO_INEN &= ~SPI_CLK_PIN;
	*pPORTFIO_SET |= SPI_CLK_PIN;
	*pPORTFIO_DIR |= SPI_CLK_PIN;
	
	*pPORTF_FER &= ~(PF2);
	*pPORTFIO_INEN |= PF2;
	*pPORTFIO_DIR &= ~PF2;
	
	//PF0 = SD	
	*pPORTF_FER &= ~(SPI_MISO_PIN);
	*pPORTFIO_INEN |= SPI_MISO_PIN;
	*pPORTFIO_DIR &= ~SPI_MISO_PIN;

}

//-----------------------------------------------------------------------------
void initialGpiosForSignalPath(void)
{
	/*
	//PH1 = RELAY_1	
	*pPORTH_FER &= ~(RELAY_1);
	*pPORTHIO_INEN &= ~RELAY_1;
	*pPORTHIO_CLEAR |= RELAY_1;
	*pPORTHIO_DIR |= RELAY_1;
	
	//PH2 = RELAY_2	
	*pPORTH_FER &= ~(RELAY_2);
	*pPORTHIO_INEN &= ~RELAY_2;
	*pPORTHIO_SET |= RELAY_2;		//Vout/Vref to Config
	*pPORTHIO_DIR |= RELAY_2;
	
	//PH3 = RELAY_3	
	*pPORTH_FER &= ~(RELAY_3);
	*pPORTHIO_INEN &= ~RELAY_3;
	*pPORTHIO_SET |= RELAY_3;
	*pPORTHIO_DIR |= RELAY_3;
	
	//PH6 = RELAY_4	
	*pPORTH_FER &= ~(RELAY_4);
	*pPORTHIO_INEN &= ~RELAY_4;
	*pPORTHIO_SET |= RELAY_4;
	*pPORTHIO_DIR |= RELAY_4;
	
	//PH5 = RELAY_5	
	*pPORTH_FER &= ~(RELAY_5);
	*pPORTHIO_INEN &= ~RELAY_5;
	*pPORTHIO_SET |= RELAY_5;
	*pPORTHIO_DIR |= RELAY_5;
	
	//PH10 = RELAY_POWERON	
	*pPORTH_FER &= ~(RELAY_POWERON);
	*pPORTHIO_INEN &= ~RELAY_POWERON;
	*pPORTHIO_CLEAR |= RELAY_POWERON;
	*pPORTHIO_DIR |= RELAY_POWERON;
	//RELAY_POWERON
	
	//PH12 = MODULE_15V_OUT	
	*pPORTH_FER &= ~(MODULE_15V_OUT);
	*pPORTHIO_INEN &= ~MODULE_15V_OUT;
	*pPORTHIO_CLEAR |= MODULE_15V_OUT;
	*pPORTHIO_DIR |= MODULE_15V_OUT;
	*/
	
	*pPORTH_FER &= ~(GPIO_1|GPIO_2|GPIO_3|GPIO_4|GPIO_5|GPIO_7|GPIO_8|GPIO_9|GPIO_10|GPIO_11|GPIO_15);
	*pPORTHIO_INEN &= ~(GPIO_1|GPIO_2|GPIO_3|GPIO_4|GPIO_5|GPIO_7|GPIO_8|GPIO_9|GPIO_10|GPIO_11|GPIO_15);
	
	*pPORTHIO_CLEAR |= GPIO_1|GPIO_11|GPIO_5;
	*pPORTHIO_SET |= GPIO_2|GPIO_3|GPIO_4|GPIO_7|GPIO_8|GPIO_9|GPIO_10|GPIO_15;
	
	*pPORTHIO_DIR |= (GPIO_1|GPIO_2|GPIO_3|GPIO_4|GPIO_5|GPIO_7|GPIO_8|GPIO_9|GPIO_10|GPIO_11);
	
	
	bInitGpiosForSignalPath = true;
	
}
