shJoshDing/SenkoMicro-SKCS-Firmware/SKSC_Firmware_RevB/SDP_ssl_init.h

/*********************************************************************************

Copyright(c) 2005 Analog Devices, Inc. All Rights Reserved. 

This software is proprietary and confidential.  By using this software you agree
to the terms of the associated Analog Devices License Agreement.  
			
*********************************************************************************/


/*********************************************************************

Include files

*********************************************************************/
#include <services/services.h>		// system service includes
#include <drivers/adi_dev.h>		/* device manager includes  */



/*********************************************************************

Definitions/Sizings

The user should modify the values in parenthesis as needed by their
application.

*********************************************************************/

#define ADI_SSL_INT_NUM_SECONDARY_HANDLERS  (12)  

#define ADI_SSL_DCB_NUM_SERVERS             (5) // number of DCB servers

#define ADI_SSL_DMA_NUM_CHANNELS            (14) // number of DMA channels

#define ADI_SSL_FLAG_NUM_CALLBACKS          (4) // number of flag callbacks (PENIRQ & KEYIRQ)
#define ADI_SSL_SEM_NUM_SEMAPHORES          (0) // number of semaphores

// number of device drivers (2x USB, 1x TWI, 2x(?)Flash, 1x SPI, 1x OTP)
#define ADI_SSL_DEV_NUM_DEVICES             (7) 

/***********************************************************************

 PLEASE READ THE FOLLOWING SECTIONS CAREFULLY.  If you do not define the following macros 
 according to your hardware, your applications may not work properly.

***********************************************************************/

/***********************************************************************
  By default the Real Time Clock is supported.
  If the application does not require the Real Time Clock uncomment the following.
***********************************************************************/

#define ADI_SSL_RTC_NO_INIT


/***********************************************************************

Handles to Services

Declare the handles to the various services and device manager.  These
handles can be used after the adi_ssl_Init() call.  

DO NOT MODIFY THIS SECTION

*********************************************************************/

//extern ADI_DMA_MANAGER_HANDLE adi_dma_ManagerHandle;   // handle to the DMA manager
//extern ADI_DEV_MANAGER_HANDLE adi_dev_ManagerHandle;   // handle to the device manager


/*********************************************************************

Critical Region Parameter

This is the value that is pased to the adi_int_EnterCriticalRegion()
function call.  This value is NULL for all current implementations.

DO NOT MODIFY THIS SECTION

*********************************************************************/

#define ADI_SSL_ENTER_CRITICAL (NULL)




/*********************************************************************

Function Declarations

Declare the intialization and termination functions.

DO NOT MODIFY THIS SECTION

*********************************************************************/

#if defined __cplusplus
    extern "C" {
#endif


u32 adiSslInit(u64 boardInitOtpWord);
u32 sdpSslUpdateSdramPll(void);
u32 adiSslTerminate(void);


#if defined __cplusplus
    }
#endif
