shJoshDing/SenkoMicro-SKCS-Firmware/(commit log)

2015-01-29 Add design docs
    @shJoshDing
    [SDP-B GPIO.xlsx]
2015-02-03 Modify +/-15V Power On and Power Off logical
    +15V and -15V power on/off have different GPIO status;
    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
    [SDP-B GPIO.xlsx]
2015-02-09 Add HDR connector signal definition file
    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
    [HDR defines.xlsx]
2015-03-23 Add HSPY power supply control
    under test
2015-03-28 Start SCH design of RevC
    [SCH20150329A.DSN, SDP-B GPIO REVB.xlsx, SDP-B GPIO REVC.xlsx]
2015-03-29 ADD BOM
    [BOM of RevC.xlsx]
2015-04-01 Add HSPY Power control supporting
2015-04-02 Modify Power Control Parameter
2015-05-06 Change SCH for RevC
    [SCH20150506A.DSN]
2015-05-19 Add finalized SCH, LAYOUT and BOM...
    [HDR defines.xlsx, RevC BOM.xlsx, RevC Components ZF.xlsx, RevC 焊接.xlsx, SCH20150329A.DSN, SCH20150506A.DSN, SDP-B GPIO REVB.xlsx, SDP-B GPIO REVC.xlsx]
